kamtar/dykodac/pcb_render.png

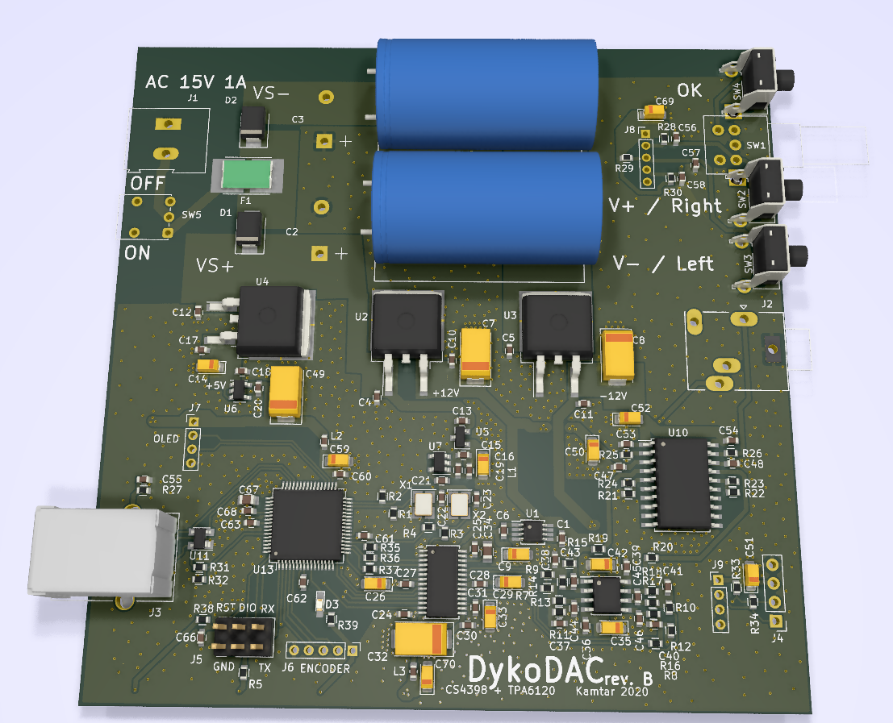
pcb_render.png
