kamtar/dykodac/pcb_design.png

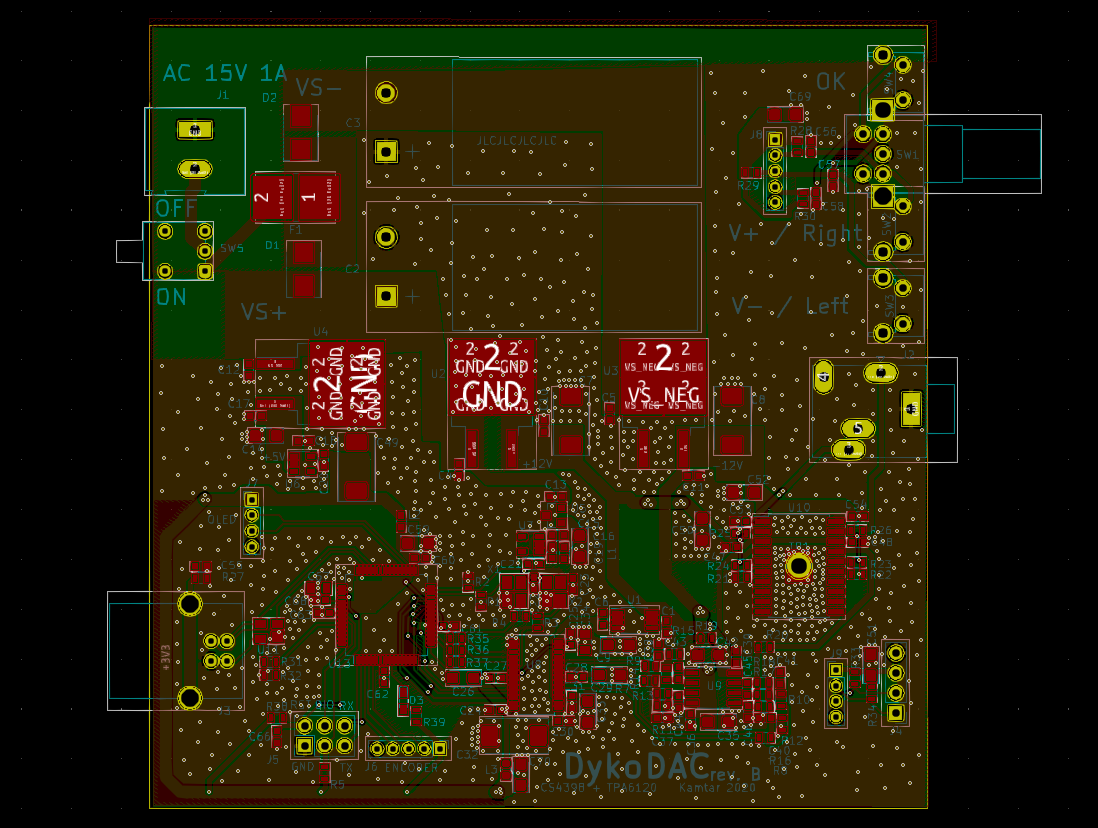
pcb_design.png
