kamtar/dykodac/schematics/DykoDAC.kicad_pcb

## KiCad design schematics/DykoDAC.kicad_pcb (2020-03-17)

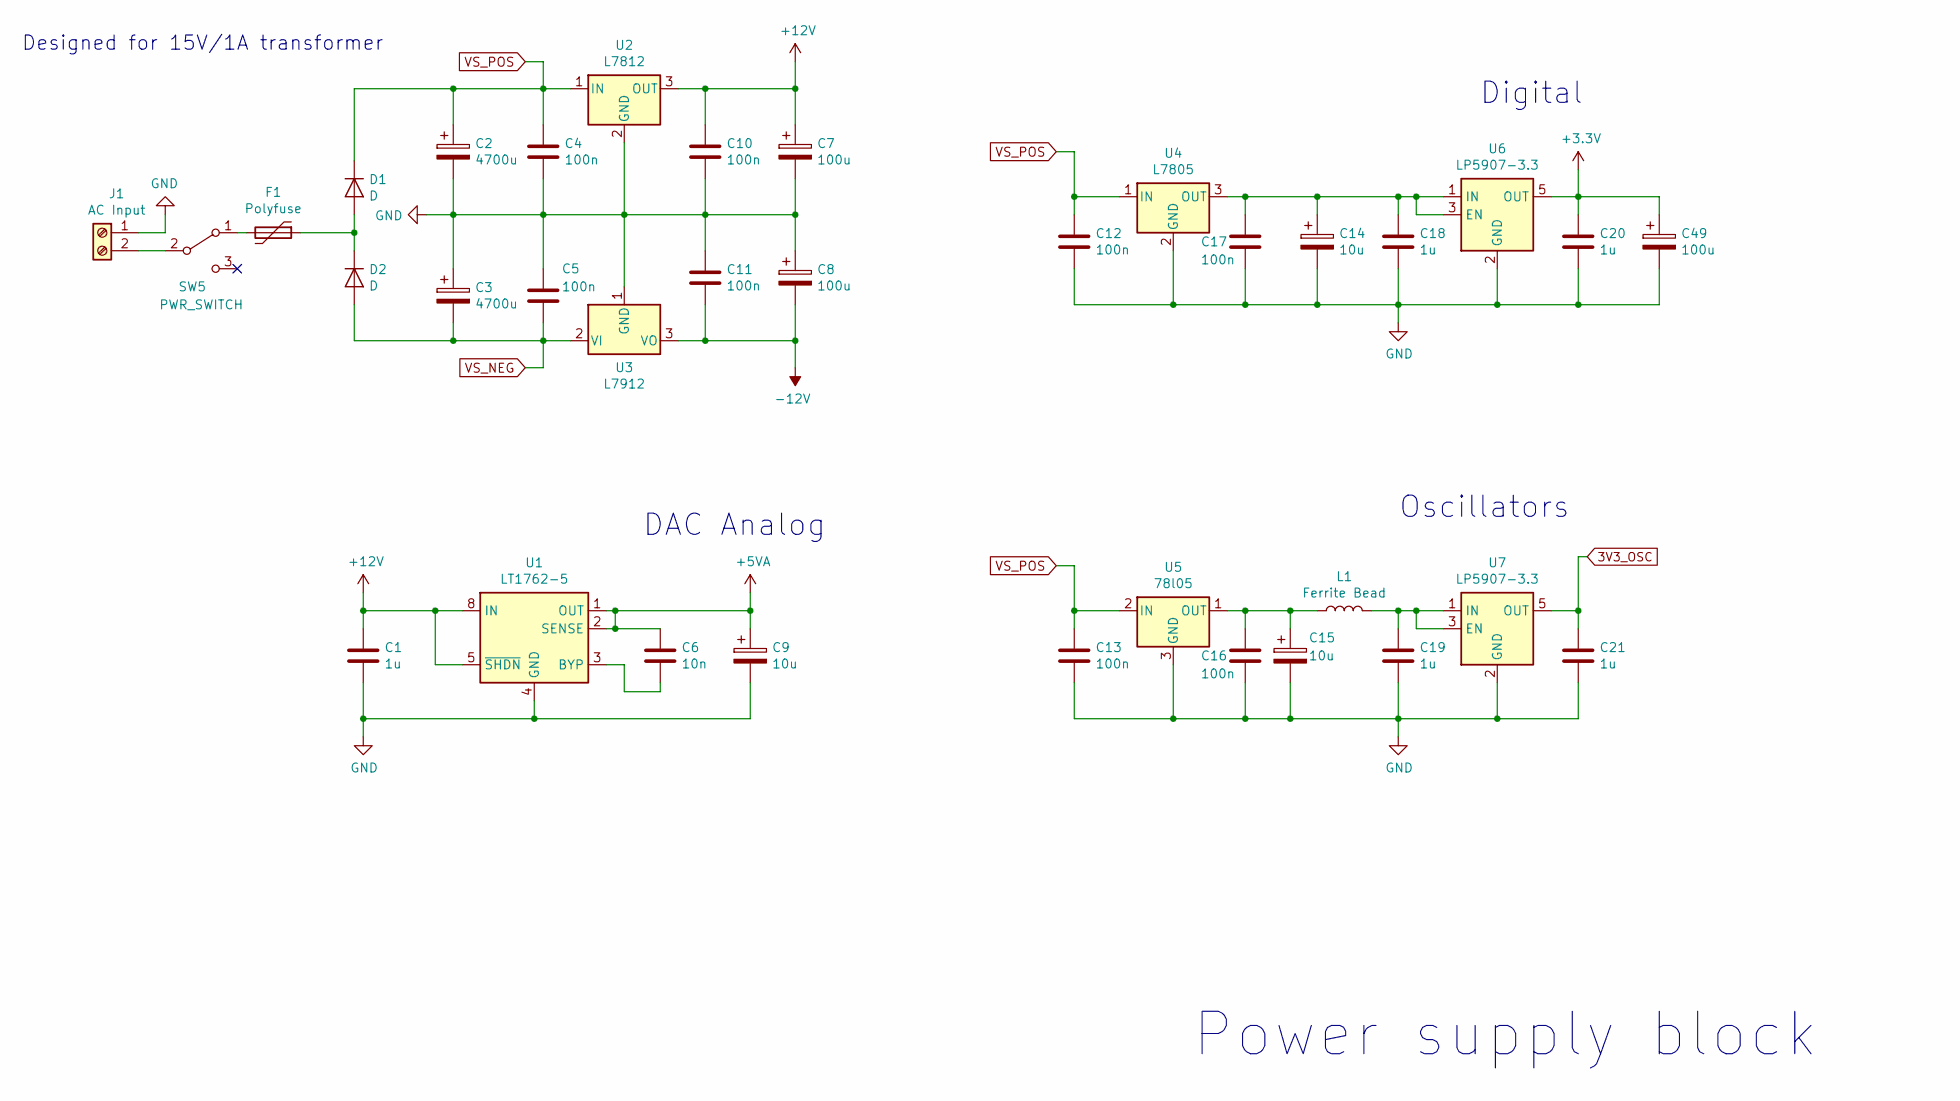
[picture p8: schematic DykoDAC_Power.sch, DykoDAC]

Parts:
C1, C18, C19, C20, C21: 1u; C_0603
C2, C3: 4700u; CP_Radial_D16.0mm_P7.50mm_Hor
C4, C5, C10, C11, C12, C13, C16, C17: 100n; C_0603
C6: 10n; C_0603
C7: 100u; CP_EIA-7343-31_Kemet-D; Part TAJD107K016SNJ
C8, C49: 100u; CP_EIA-7343-31_Kemet-D
C9: 10u; CP_EIA-3216-18_Kemet-A; Part T491A106K016AT
C14, C15: 10u; CP_EIA-3216-18_Kemet-A
D1, D2: D; D_SMB
F1: Polyfuse; UNIFuse_SMD2920
J1: AC Input; TerminalBlock_Altech_AK300-2_P5.00mm
L1: Ferrite Bead; C_0603
SW5: PWR_SWITCH; SW_Push_1P2T_Vertical_E-Switch_800UDP8P1A1M6
U1: LT1762-5; MSOP-8_3x3mm_Pitch0.65mm
U2: L7812; TO-263-2
U3: L7912; TO-263-2
U4: L7805; TO-263-2
U5: 78l05; SOT-23
U6, U7: LP5907-3.3; SOT-23-5

Connections:
3V3_OSC: C21.1, U7.5 (OUT); also elsewhere on the board
+5VA: C6.1, C9.1, U1.1 (OUT), U1.2 (SENSE); also elsewhere on the board
+12V: C1.1, C7.1, C10.1, U1.5 (~SHDN), U1.8 (IN), U2.3 (OUT); also elsewhere on the board
-12V: C8.2, C11.2, U3.3 (VO); also elsewhere on the board
GND: C1.2, C2.2, C3.1, C4.2, C5.1, C7.2, C8.1, C9.2, C10.2, C11.1, C12.2, C13.2, C14.2, C15.2, C16.2, C17.2, C18.2, C19.2, C20.2, C21.2, C49.2, J1.1, U1.4 (GND), U2.2 (GND), U3.1 (GND), U4.2 (GND), U5.3 (GND), U6.2 (GND), U7.2 (GND); also elsewhere on the board
unnamed: C6.2, U1.3 (BYP)
unnamed: C14.1, C17.1, C18.1, U4.3 (OUT), U6.1 (IN), U6.3 (EN)
unnamed: C15.1, C16.1, L1.1, U5.1 (OUT)
unnamed: C19.1, L1.2, U7.1 (IN), U7.3 (EN)
unnamed: D1.2 (A), D2.1 (K), F1.1
unnamed: F1.2, SW5.1 (A)
unnamed: J1.2, SW5.2 (B)
VS_NEG: C3.2, C5.2, D2.2 (A), U3.2 (VI)
VS_POS: C2.1, C4.1, C12.1, C13.1, D1.1 (K), U2.1 (IN), U4.1 (IN), U5.2 (IN)

Notes on the sheet:
Digital
DAC Analog
Power supply block
Oscillators
Designed for 15V/1A transformer

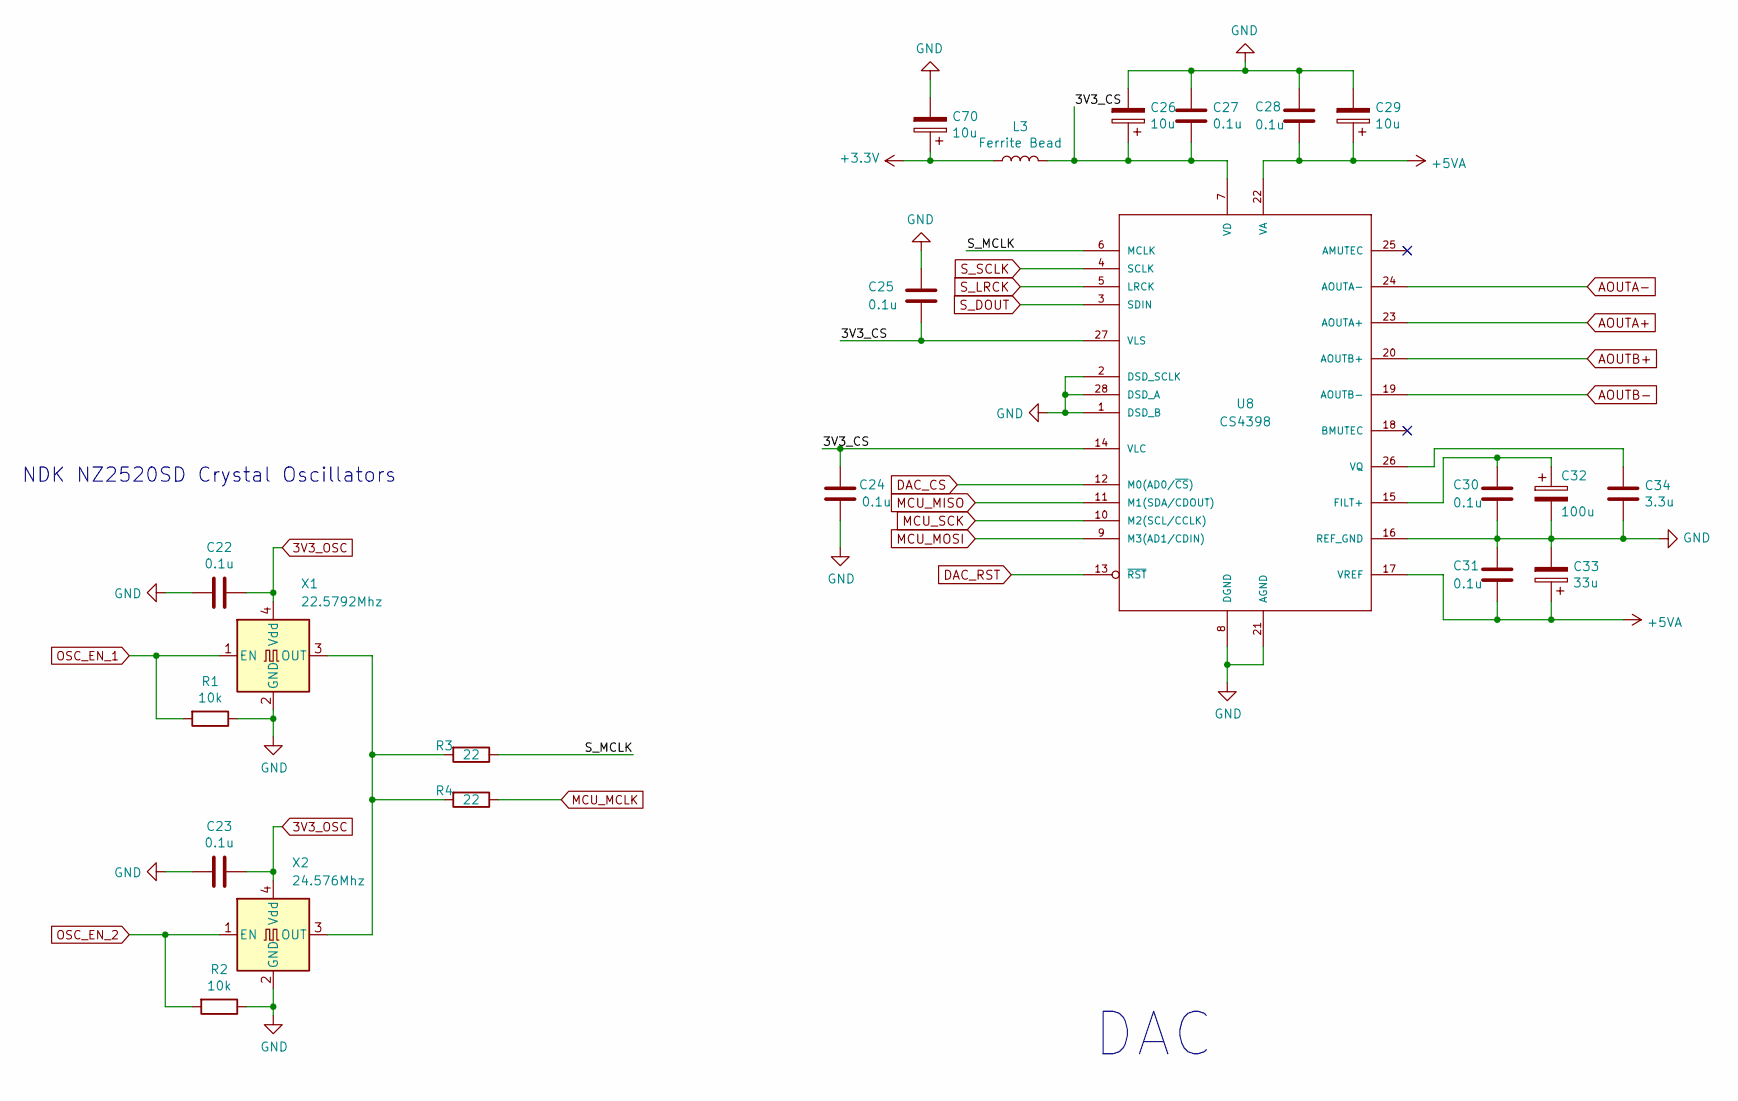
[picture p9: schematic DykoDAC_CS4398.sch, DykoDAC]

Parts:
C22, C23, C24, C25, C27, C28, C30, C31: 0.1u; C_0603
C26, C29, C70: 10u; CP_EIA-3216-18_Kemet-A
C32: 100u; CP_EIA-7343-31_Kemet-D; Part TAJD107K016SNJ
C33: 33u; CP_EIA-3216-18_Kemet-A
C34: 3.3u; C_0805
L3: Ferrite Bead; C_0603_1608Metric
R1, R2: 10k; R_0603
R3, R4: 22; R_0603
U8: CS4398; TSSOP-28_4.4x9.7mm_Pitch0.65mm
X1: 22.5792Mhz; Oscillator_SMD_SeikoEpson_SG210-4pin_2.5x2.0mm_HandSoldering; Part NDK NZ2520SD
X2: 24.576Mhz; Oscillator_SMD_SeikoEpson_SG210-4pin_2.5x2.0mm_HandSoldering; Part NDK NZ2520SD

Connections:
3V3_OSC: C22.1, C23.1, X1.4 (Vdd), X2.4 (Vdd); also elsewhere on the board
+5VA: C28.2, C29.1, C31.2, C33.1, U8.17 (VREF), U8.22 (VA); also elsewhere on the board
/DykoDAC_CS4398/3V3_CS: C24.1, C25.1, C26.1, C27.1, L3.2, U8.7 (VD), U8.14 (VLC), U8.27 (VLS)
/DykoDAC_CS4398/S_MCLK: R3.1, U8.6 (MCLK)
AOUTA+: U8.23 (AOUTA+); also elsewhere on the board
AOUTA-: U8.24 (AOUTA-); also elsewhere on the board
AOUTB+: U8.20 (AOUTB+); also elsewhere on the board
AOUTB-: U8.19 (AOUTB-); also elsewhere on the board
DAC_CS: U8.12 (M0(AD0/~CS~)); also elsewhere on the board
DAC_RST: U8.13 (~RST); also elsewhere on the board
GND: C22.2, C23.2, C24.2, C25.2, C26.2, C27.2, C28.1, C29.2, C30.2, C31.1, C32.2, C33.2, C34.2, C70.2, R1.1, R2.1, U8.1 (DSD_B), U8.2 (DSD_SCLK), U8.8 (DGND), U8.16 (REF_GND), U8.21 (AGND), U8.28 (DSD_A), X1.2 (GND), X2.2 (GND); also elsewhere on the board
MCU_MCLK: R4.1; also elsewhere on the board
MCU_MISO: U8.11 (M1(SDA/CDOUT)); also elsewhere on the board
MCU_MOSI: U8.9 (M3(AD1/CDIN)); also elsewhere on the board
MCU_SCK: U8.10 (M2(SCL/CCLK)); also elsewhere on the board
unnamed: C30.1, C32.1, U8.15 (FILT+)
unnamed: C34.1, U8.26 (VQ)
unnamed: R3.2, R4.2, X1.3 (OUT), X2.3 (OUT)
OSC_EN_1: R1.2, X1.1 (EN); also elsewhere on the board
OSC_EN_2: R2.2, X2.1 (EN); also elsewhere on the board
S_DOUT: U8.3 (SDIN); also elsewhere on the board
S_LRCK: U8.5 (LRCK); also elsewhere on the board
S_SCLK: U8.4 (SCLK); also elsewhere on the board

Notes on the sheet:
DAC
NDK NZ2520SD Crystal Oscillators

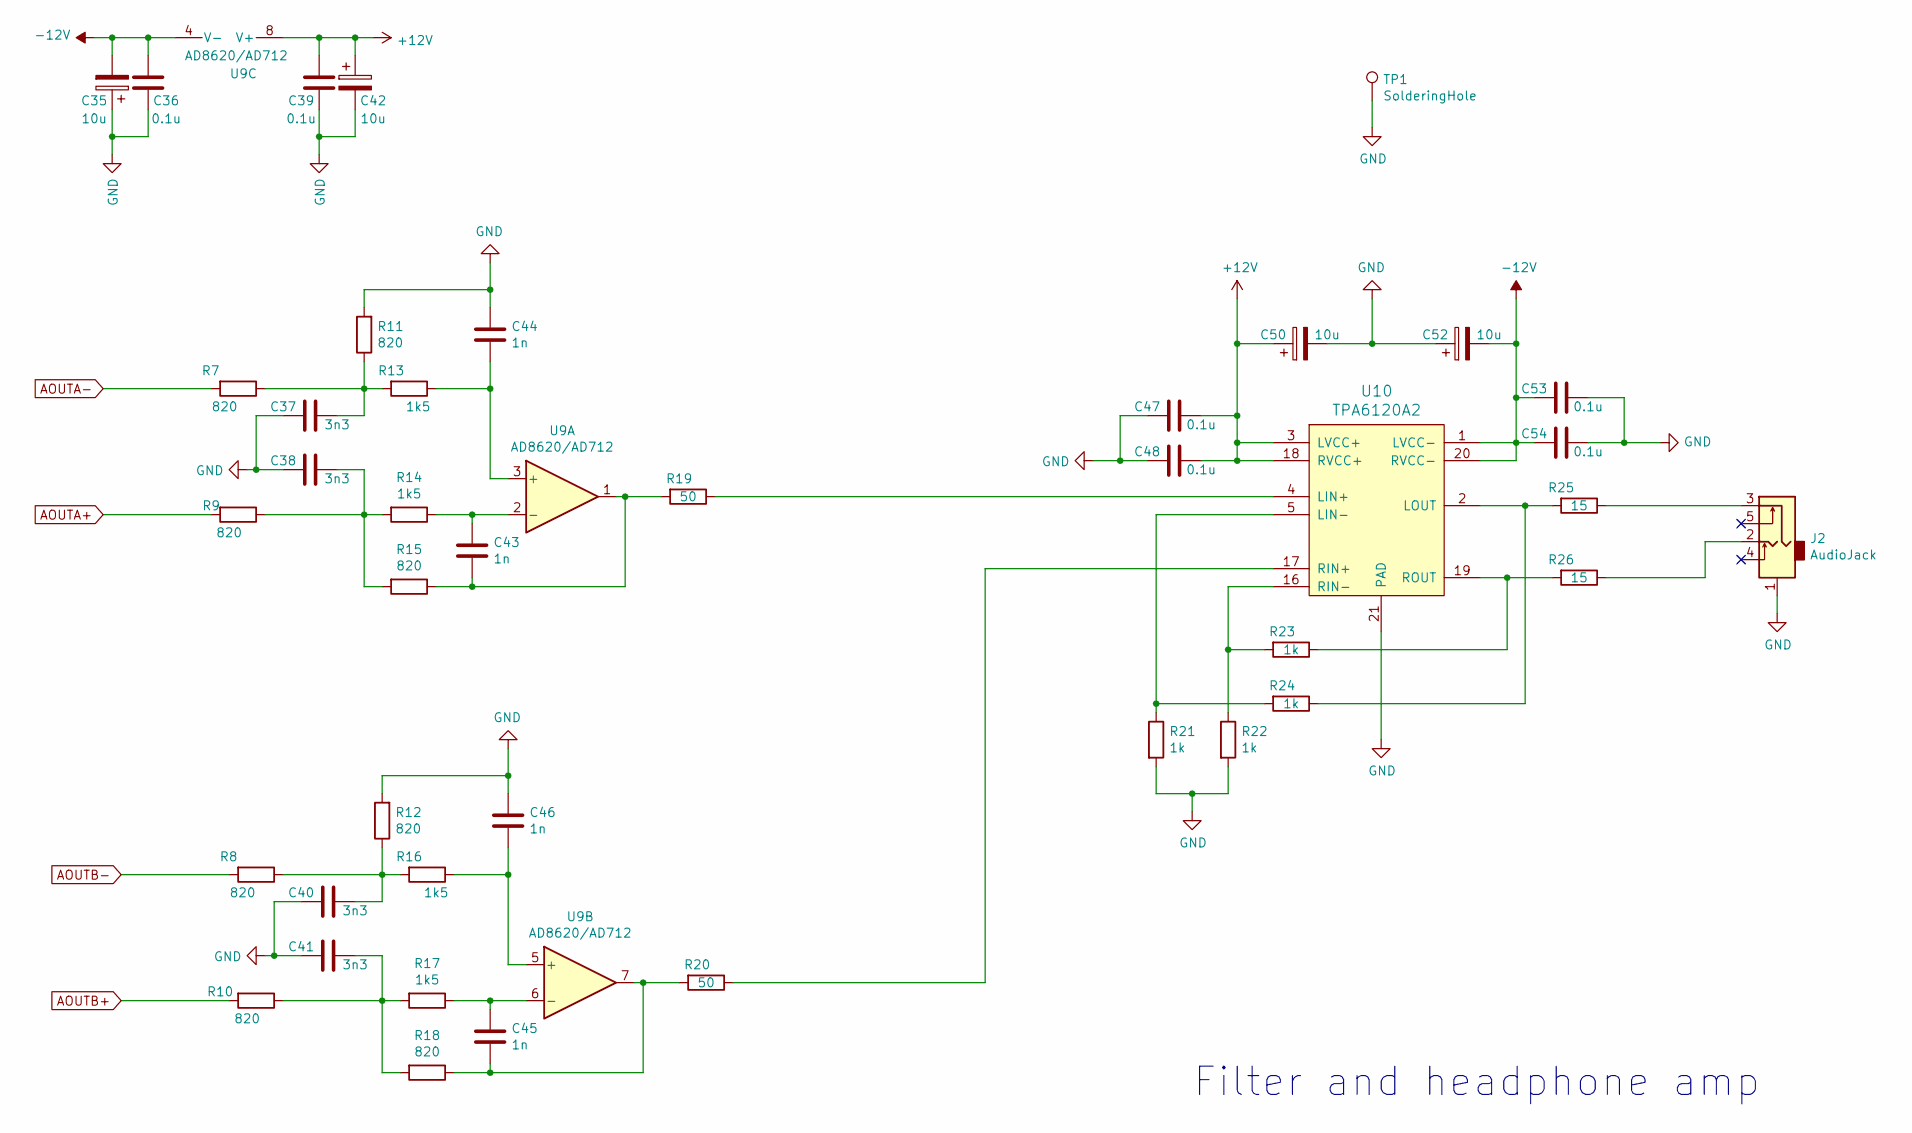
[picture p10: schematic DykoDAC_Output.sch, DykoDAC]

Parts:
C35, C42, C50, C52: 10u; CP_EIA-3216-18_Kemet-A
C36, C39, C47, C48, C53, C54: 0.1u; C_0603
C37, C38, C40, C41: 3n3; C_0603
C43, C44, C45, C46: 1n; C_0603
J2: AudioJack; StereoJack_3.5mm_Lumberg
R7, R8, R9, R10, R11, R12, R15, R18: 820; R_0603
R13, R14, R16, R17: 1k5; R_0603
R19, R20: 50; R_0603
R21, R22, R23, R24: 1k; R_0603
R25, R26: 15; R_0603
TP1: SolderingHole; TestPoint_Plated_Hole_D2.0mm
U9: AD8620/AD712; SOIC-8_3.9x4.9mm_Pitch1.27mm
U10: TPA6120A2; SOIC-20W_ThermalPad

Connections:
+12V: C39.2, C42.1, C47.1, C48.1, C50.1, U9.8 (V+), U10.3 (LVCC+), U10.18 (RVCC+); also elsewhere on the board
-12V: C35.2, C36.2, C52.2, C53.2, C54.2, U9.4 (V-), U10.1 (LVCC-), U10.20 (RVCC-); also elsewhere on the board
AOUTA+: R9.2; also elsewhere on the board
AOUTA-: R7.2; also elsewhere on the board
AOUTB+: R10.2; also elsewhere on the board
AOUTB-: R8.2; also elsewhere on the board
GND: C35.1, C36.1, C37.2, C38.2, C39.1, C40.2, C41.2, C42.2, C44.1, C46.1, C47.2, C48.2, C50.2, C52.1, C53.1, C54.1, J2.1, R11.2, R12.2, R21.2, R22.2, TP1.1, U10.21 (PAD); also elsewhere on the board
unnamed: C37.1, R7.1, R11.1, R13.2
unnamed: C38.1, R9.1, R14.2, R15.2
unnamed: C40.1, R8.1, R12.1, R16.2
unnamed: C41.1, R10.1, R17.2, R18.2
unnamed: C43.1, R14.1, U9.2 (-)
unnamed: C43.2, R15.1, R19.2, U9.1
unnamed: C44.2, R13.1, U9.3 (+)
unnamed: C45.1, R17.1, U9.6 (-)
unnamed: C45.2, R18.1, R20.2, U9.7
unnamed: C46.2, R16.1, U9.5 (+)
unnamed: J2.2, R26.1
unnamed: J2.3, R25.1
unnamed: R19.1, U10.4 (LIN+)
unnamed: R20.1, U10.17 (RIN+)
unnamed: R21.1, R24.2, U10.5 (LIN-)
unnamed: R22.1, R23.2, U10.16 (RIN-)
unnamed: R23.1, R26.2, U10.19 (ROUT)
unnamed: R24.1, R25.2, U10.2 (LOUT)

Notes on the sheet:
Filter and headphone amp

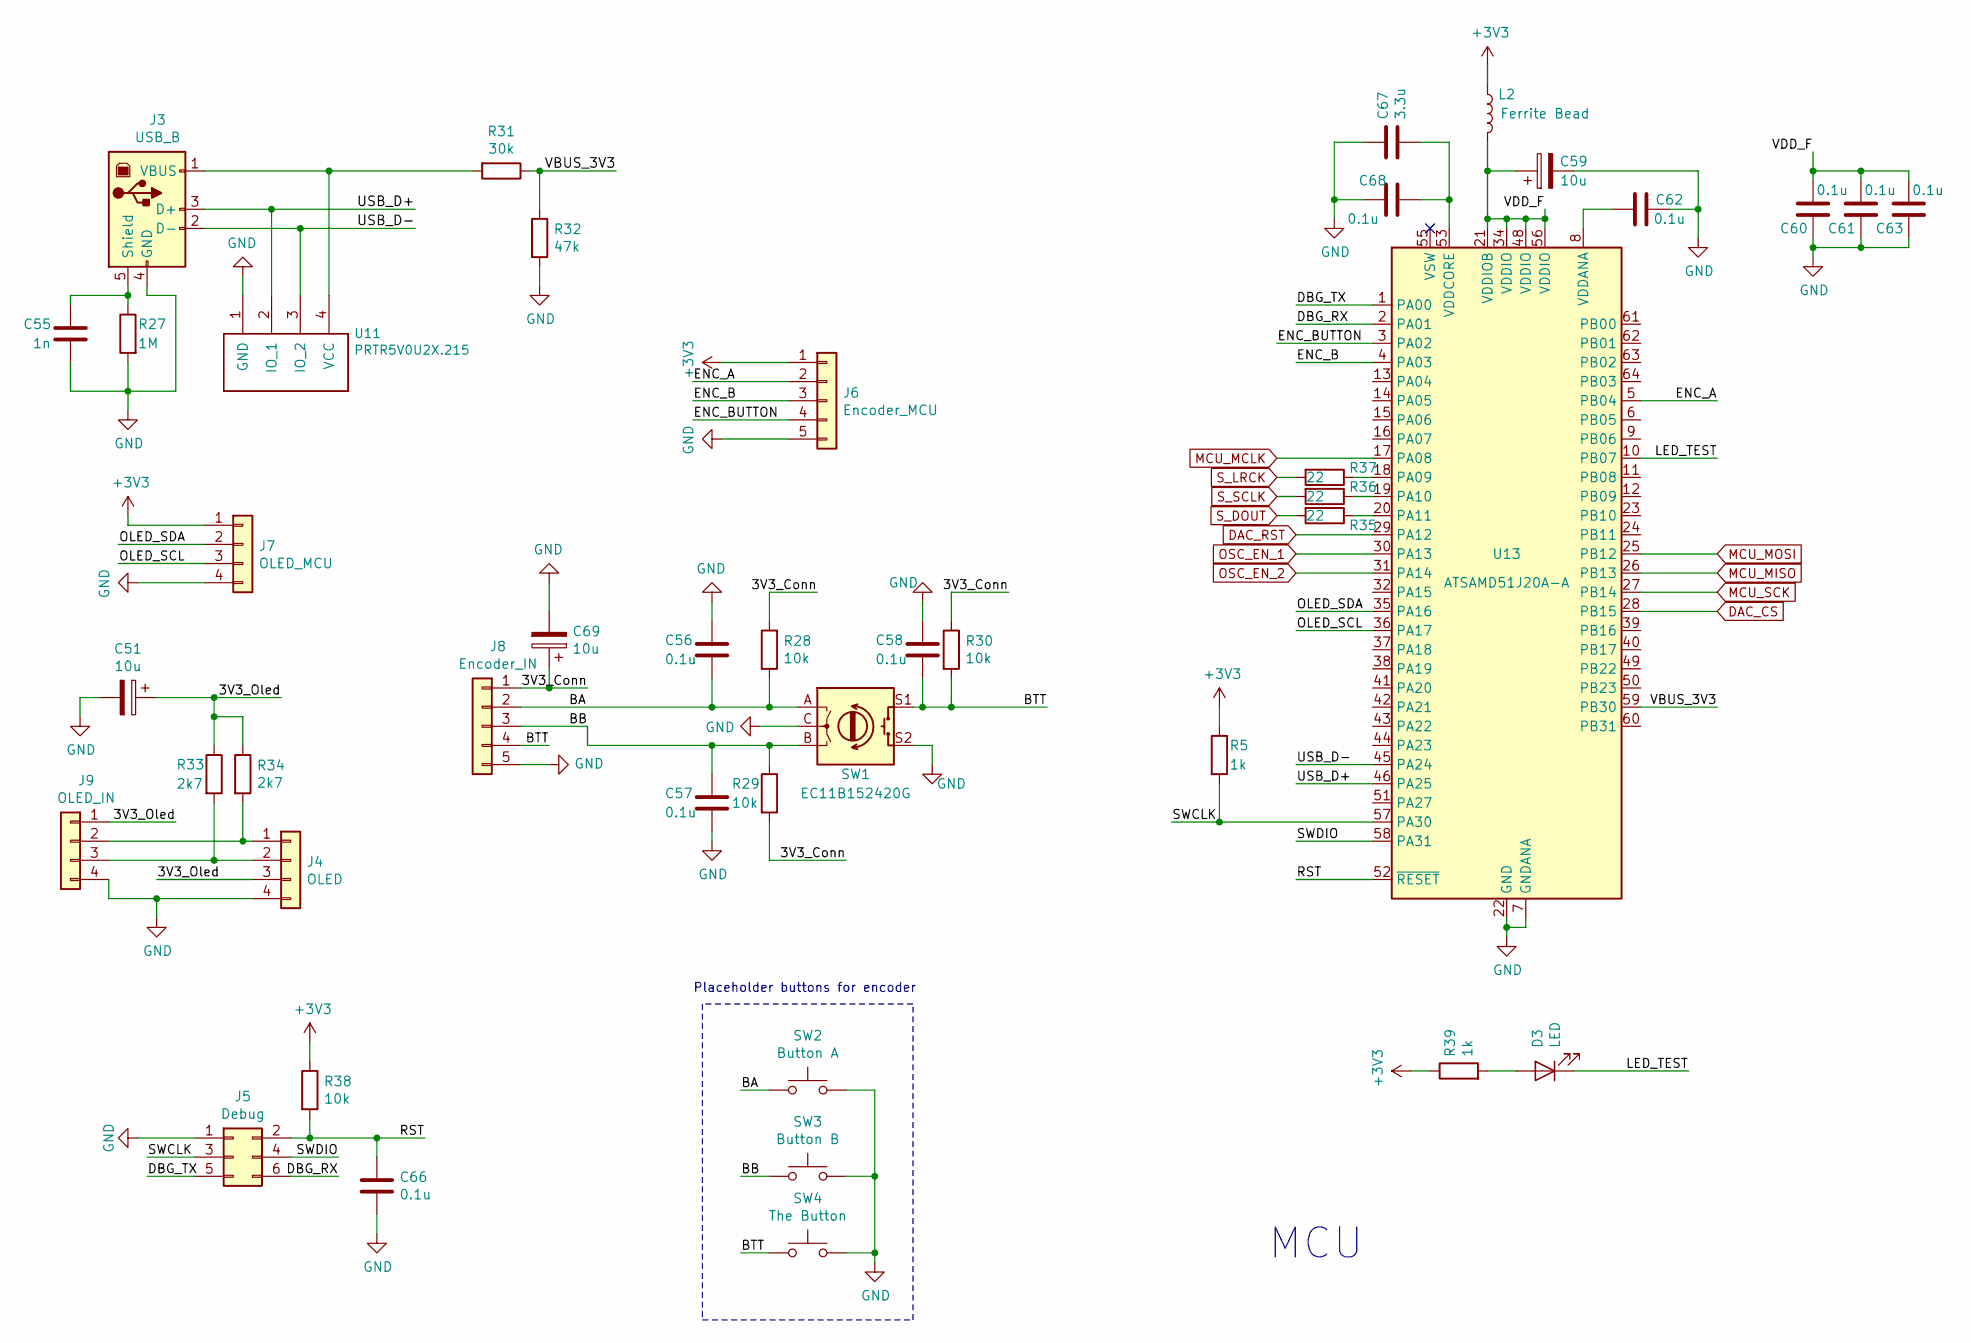
[picture p11: schematic DykoDAC_MCU.sch]

Parts:
C51, C59, C69: 10u; CP_EIA-3216-18_Kemet-A
C55: 1n; C_0603
C56, C57, C58, C60, C61, C62, C63, C66, C68: 0.1u; C_0603
C67: 3.3u; C_0805
D3: LED; LED_0603_HandSoldering
J3: USB_B
J4: OLED; Pin_Header_Straight_1x04_Pitch2.54mm
J5: Debug; Pin_Header_Straight_2x03_Pitch2.54mm
J6: Encoder_MCU; Pin_Header_Straight_1x05_Pitch2.00mm
J7: OLED_MCU; Pin_Header_Straight_1x04_Pitch2.00mm
J8: Encoder_IN; Pin_Header_Straight_1x05_Pitch2.00mm
J9: OLED_IN; Pin_Header_Straight_1x04_Pitch2.00mm
L2: Ferrite Bead; C_0603
R5, R39: 1k; R_0603
R27: 1M; R_0603
R28, R29, R30, R38: 10k; R_0603
R31: 30k; R_0603
R32: 47k; R_0603
R33, R34: 2k7; R_0603
R35, R36, R37: 22; R_0603
SW1: EC11B152420G; Potentiometer_Alps_RK097_Dual_Horizontal
SW2: Button A; SW_Tactile_SPST_Angled_PTS645Vx58-2LFS
SW3: Button B; SW_Tactile_SPST_Angled_PTS645Vx58-2LFS
SW4: The Button; SW_Tactile_SPST_Angled_PTS645Vx58-2LFS
U11: PRTR5V0U2X.215; SOT-143
U13: ATSAMD51J20A-A; LQFP-64_10x10mm_Pitch0.5mm

Connections:
/DykoDAC_MCU/3V3_Conn: C69.1, J8.1, R28.1, R29.2, R30.1
/DykoDAC_MCU/3V3_Oled: C51.1, J4.3, J9.1, R33.1, R34.1
/DykoDAC_MCU/BA: C56.2, J8.2, R28.2, SW1.A, SW2.1
/DykoDAC_MCU/BB: C57.1, J8.3, R29.1, SW1.B, SW3.1
/DykoDAC_MCU/BTT: C58.2, J8.4, R30.2, SW1.S1, SW4.1
/DykoDAC_MCU/DBG_RX: J5.6, U13.2 (PA01)
/DykoDAC_MCU/DBG_TX: J5.5, U13.1 (PA00)
/DykoDAC_MCU/ENC_A: J6.2, U13.5 (PB04)
/DykoDAC_MCU/ENC_B: J6.3, U13.4 (PA03)
/DykoDAC_MCU/ENC_BUTTON: J6.4, U13.3 (PA02)
/DykoDAC_MCU/LED_TEST: D3.1 (K), U13.10 (PB07)
/DykoDAC_MCU/OLED_SCL: J7.3, U13.36 (PA17)
/DykoDAC_MCU/OLED_SDA: J7.2, U13.35 (PA16)
/DykoDAC_MCU/RST: C66.1, J5.2, R38.2, U13.52 (~RESET)
/DykoDAC_MCU/SWCLK: J5.3, R5.2, U13.57 (PA30)
/DykoDAC_MCU/SWDIO: J5.4, U13.58 (PA31)
/DykoDAC_MCU/USB_D+: J3.3 (D+), U11.2 (IO_1), U13.46 (PA25)
/DykoDAC_MCU/USB_D-: J3.2 (D-), U11.3 (IO_2), U13.45 (PA24)
/DykoDAC_MCU/VBUS_3V3: R31.1, R32.1, U13.59 (PB30)
/DykoDAC_MCU/VDD_F: C59.1, C60.2, C61.2, C63.2, L2.2, U13.21 (VDDIOB), U13.34 (VDDIO), U13.48 (VDDIO), U13.56 (VDDIO)
DAC_CS: U13.28 (PB15); also elsewhere on the board
DAC_RST: U13.29 (PA12); also elsewhere on the board
GND: C51.2, C55.2, C56.1, C57.2, C58.1, C59.2, C60.1, C61.1, C62.1, C63.1, C66.2, C67.1, C68.2, C69.2, J3.4 (GND), J4.4, J5.1, J6.5, J7.4, J8.5, J9.4, R27.2, R32.2, SW1.C, SW1.S2, SW2.2, SW3.2, SW4.2, U11.1 (GND), U13.7 (GNDANA), U13.22 (GND), U13.33 (GND), U13.47 (GND), U13.54 (GND); also elsewhere on the board
MCU_MCLK: U13.17 (PA08); also elsewhere on the board
MCU_MISO: U13.26 (PB13); also elsewhere on the board
MCU_MOSI: U13.25 (PB12); also elsewhere on the board
MCU_SCK: U13.27 (PB14); also elsewhere on the board
unnamed: C55.1, J3.5 (Shield), R27.1
unnamed: C62.2, U13.8 (VDDANA)
unnamed: C67.2, C68.1, U13.53 (VDDCORE)
unnamed: D3.2 (A), R39.2
unnamed: J3.1 (VBUS), R31.2, U11.4 (VCC)
unnamed: J4.1, J9.2, R34.2
unnamed: J4.2, J9.3, R33.2
unnamed: R35.1, U13.20 (PA11)
unnamed: R36.1, U13.19 (PA10)
unnamed: R37.1, U13.18 (PA09)
OSC_EN_1: U13.30 (PA13); also elsewhere on the board
OSC_EN_2: U13.31 (PA14); also elsewhere on the board
S_DOUT: R35.2; also elsewhere on the board
S_LRCK: R37.2; also elsewhere on the board
S_SCLK: R36.2; also elsewhere on the board

Notes on the sheet:
MCU
Placeholder buttons for encoder

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
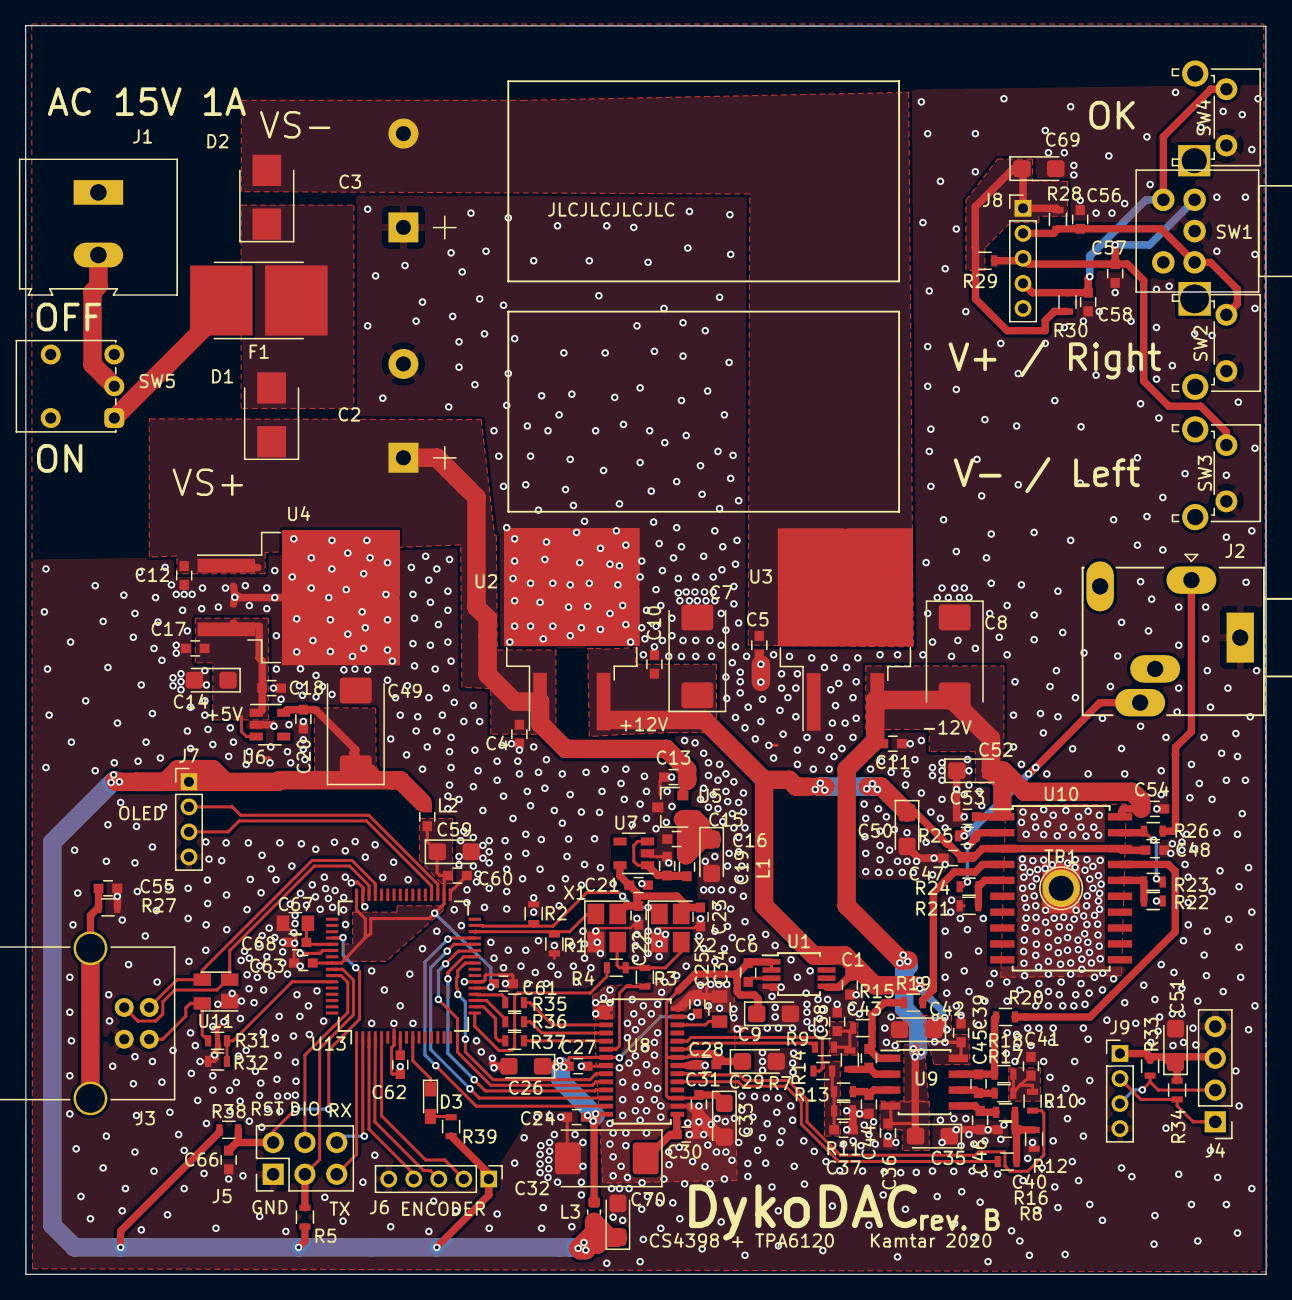
[picture p12: board DykoDAC.kicad_pcb from above]

Board: 2 copper layers, 99.2 x 99.8 mm, 142 parts (0 on the bottom side), 83 nets.
