kamtar/dykodac/fw/src/driver_init.c

/*
 * Code generated from Atmel Start.
 *
 * This file will be overwritten when reconfiguring your Atmel Start project.
 * Please copy examples or other code you want to keep to a separate file
 * to avoid losing it when reconfiguring.
 */

#include "driver_init.h"
#include <peripheral_clk_config.h>
#include <utils.h>
#include <hal_init.h>

#include <hpl_rtc_base.h>

struct timer_descriptor      TIMER_0;
struct spi_m_sync_descriptor SPI_0;

struct i2s_c_sync_desc I2S_0_0;

struct flash_descriptor FLASH_0;


struct i2c_m_sync_desc I2C_0;

struct wdt_descriptor WDT_0;

void EVENT_SYSTEM_0_init(void)
{

	hri_mclk_set_APBBMASK_EVSYS_bit(MCLK);

	event_system_init();
}

void I2S_0_PORT_init(void)
{

	gpio_set_pin_direction(PA09,
	                       // <y> Pin direction
	                       // <id> pad_direction
	                       // <GPIO_DIRECTION_OFF"> Off
	                       // <GPIO_DIRECTION_IN"> In
	                       // <GPIO_DIRECTION_OUT"> Out
	                       GPIO_DIRECTION_OUT);

	gpio_set_pin_level(PA09,
	                   // <y> Initial level
	                   // <id> pad_initial_level
	                   // <false"> Low
	                   // <true"> High
	                   false);

	gpio_set_pin_pull_mode(PA09,
	                       // <y> Pull configuration
	                       // <id> pad_pull_config
	                       // <GPIO_PULL_OFF"> Off
	                       // <GPIO_PULL_UP"> Pull-up
	                       // <GPIO_PULL_DOWN"> Pull-down
	                       GPIO_PULL_OFF);

	gpio_set_pin_function(PA09,
	                      // <y> Pin function
	                      // <id> pad_function
	                      // <i> Auto : use driver pinmux if signal is imported by driver, else turn off function
	                      // <PINMUX_PA09J_I2S_FS0"> Auto
	                      // <GPIO_PIN_FUNCTION_OFF"> Off
	                      // <GPIO_PIN_FUNCTION_A"> A
	                      // <GPIO_PIN_FUNCTION_B"> B
	                      // <GPIO_PIN_FUNCTION_C"> C
	                      // <GPIO_PIN_FUNCTION_D"> D
	                      // <GPIO_PIN_FUNCTION_E"> E
	                      // <GPIO_PIN_FUNCTION_F"> F
	                      // <GPIO_PIN_FUNCTION_G"> G
	                      // <GPIO_PIN_FUNCTION_H"> H
	                      // <GPIO_PIN_FUNCTION_I"> I
	                      // <GPIO_PIN_FUNCTION_J"> J
	                      // <GPIO_PIN_FUNCTION_K"> K
	                      // <GPIO_PIN_FUNCTION_L"> L
	                      // <GPIO_PIN_FUNCTION_M"> M
	                      // <GPIO_PIN_FUNCTION_N"> N
	                      PINMUX_PA09J_I2S_FS0);

	gpio_set_pin_direction(PA08,
	                       // <y> Pin direction
	                       // <id> pad_direction
	                       // <GPIO_DIRECTION_OFF"> Off
	                       // <GPIO_DIRECTION_IN"> In
	                       // <GPIO_DIRECTION_OUT"> Out
	                       GPIO_DIRECTION_IN);

	gpio_set_pin_level(PA08,
	                   // <y> Initial level
	                   // <id> pad_initial_level
	                   // <false"> Low
	                   // <true"> High
	                   false);

	gpio_set_pin_pull_mode(PA08,
	                       // <y> Pull configuration
	                       // <id> pad_pull_config
	                       // <GPIO_PULL_OFF"> Off
	                       // <GPIO_PULL_UP"> Pull-up
	                       // <GPIO_PULL_DOWN"> Pull-down
	                       GPIO_PULL_OFF);

	gpio_set_pin_function(PA08,
	                      // <y> Pin function
	                      // <id> pad_function
	                      // <i> Auto : use driver pinmux if signal is imported by driver, else turn off function
	                      // <PINMUX_PA08J_I2S_MCK0"> Auto
	                      // <GPIO_PIN_FUNCTION_OFF"> Off
	                      // <GPIO_PIN_FUNCTION_A"> A
	                      // <GPIO_PIN_FUNCTION_B"> B
	                      // <GPIO_PIN_FUNCTION_C"> C
	                      // <GPIO_PIN_FUNCTION_D"> D
	                      // <GPIO_PIN_FUNCTION_E"> E
	                      // <GPIO_PIN_FUNCTION_F"> F
	                      // <GPIO_PIN_FUNCTION_G"> G
	                      // <GPIO_PIN_FUNCTION_H"> H
	                      // <GPIO_PIN_FUNCTION_I"> I
	                      // <GPIO_PIN_FUNCTION_J"> J
	                      // <GPIO_PIN_FUNCTION_K"> K
	                      // <GPIO_PIN_FUNCTION_L"> L
	                      // <GPIO_PIN_FUNCTION_M"> M
	                      // <GPIO_PIN_FUNCTION_N"> N
	                      PINMUX_PA08J_I2S_MCK0);

	gpio_set_pin_direction(PA10,
	                       // <y> Pin direction
	                       // <id> pad_direction
	                       // <GPIO_DIRECTION_OFF"> Off
	                       // <GPIO_DIRECTION_IN"> In
	                       // <GPIO_DIRECTION_OUT"> Out
	                       GPIO_DIRECTION_OUT);

	gpio_set_pin_level(PA10,
	                   // <y> Initial level
	                   // <id> pad_initial_level
	                   // <false"> Low
	                   // <true"> High
	                   false);

	gpio_set_pin_pull_mode(PA10,
	                       // <y> Pull configuration
	                       // <id> pad_pull_config
	                       // <GPIO_PULL_OFF"> Off
	                       // <GPIO_PULL_UP"> Pull-up
	                       // <GPIO_PULL_DOWN"> Pull-down
	                       GPIO_PULL_OFF);

	gpio_set_pin_function(PA10,
	                      // <y> Pin function
	                      // <id> pad_function
	                      // <i> Auto : use driver pinmux if signal is imported by driver, else turn off function
	                      // <PINMUX_PA10J_I2S_SCK0"> Auto
	                      // <GPIO_PIN_FUNCTION_OFF"> Off
	                      // <GPIO_PIN_FUNCTION_A"> A
	                      // <GPIO_PIN_FUNCTION_B"> B
	                      // <GPIO_PIN_FUNCTION_C"> C
	                      // <GPIO_PIN_FUNCTION_D"> D
	                      // <GPIO_PIN_FUNCTION_E"> E
	                      // <GPIO_PIN_FUNCTION_F"> F
	                      // <GPIO_PIN_FUNCTION_G"> G
	                      // <GPIO_PIN_FUNCTION_H"> H
	                      // <GPIO_PIN_FUNCTION_I"> I
	                      // <GPIO_PIN_FUNCTION_J"> J
	                      // <GPIO_PIN_FUNCTION_K"> K
	                      // <GPIO_PIN_FUNCTION_L"> L
	                      // <GPIO_PIN_FUNCTION_M"> M
	                      // <GPIO_PIN_FUNCTION_N"> N
	                      PINMUX_PA10J_I2S_SCK0);

	gpio_set_pin_direction(PA11,
	                       // <y> Pin direction
	                       // <id> pad_direction
	                       // <GPIO_DIRECTION_OFF"> Off
	                       // <GPIO_DIRECTION_IN"> In
	                       // <GPIO_DIRECTION_OUT"> Out
	                       GPIO_DIRECTION_OUT);

	gpio_set_pin_level(PA11,
	                   // <y> Initial level
	                   // <id> pad_initial_level
	                   // <false"> Low
	                   // <true"> High
	                   false);

	gpio_set_pin_pull_mode(PA11,
	                       // <y> Pull configuration
	                       // <id> pad_pull_config
	                       // <GPIO_PULL_OFF"> Off
	                       // <GPIO_PULL_UP"> Pull-up
	                       // <GPIO_PULL_DOWN"> Pull-down
	                       GPIO_PULL_OFF);

	gpio_set_pin_function(PA11,
	                      // <y> Pin function
	                      // <id> pad_function
	                      // <i> Auto : use driver pinmux if signal is imported by driver, else turn off function
	                      // <PINMUX_PA11J_I2S_SDO"> Auto
	                      // <GPIO_PIN_FUNCTION_OFF"> Off
	                      // <GPIO_PIN_FUNCTION_A"> A
	                      // <GPIO_PIN_FUNCTION_B"> B
	                      // <GPIO_PIN_FUNCTION_C"> C
	                      // <GPIO_PIN_FUNCTION_D"> D
	                      // <GPIO_PIN_FUNCTION_E"> E
	                      // <GPIO_PIN_FUNCTION_F"> F
	                      // <GPIO_PIN_FUNCTION_G"> G
	                      // <GPIO_PIN_FUNCTION_H"> H
	                      // <GPIO_PIN_FUNCTION_I"> I
	                      // <GPIO_PIN_FUNCTION_J"> J
	                      // <GPIO_PIN_FUNCTION_K"> K
	                      // <GPIO_PIN_FUNCTION_L"> L
	                      // <GPIO_PIN_FUNCTION_M"> M
	                      // <GPIO_PIN_FUNCTION_N"> N
	                      PINMUX_PA11J_I2S_SDO);
}

void I2S_0_CLOCK_init(void)
{
	hri_mclk_set_APBDMASK_I2S_bit(MCLK);
	hri_gclk_write_PCHCTRL_reg(GCLK, I2S_GCLK_ID_0, CONF_GCLK_I2S_SRC_0 | (1 << GCLK_PCHCTRL_CHEN_Pos));
	hri_gclk_write_PCHCTRL_reg(GCLK, I2S_GCLK_ID_1, CONF_GCLK_I2S_SRC_1 | (1 << GCLK_PCHCTRL_CHEN_Pos));
}

void I2S_0_init(void)
{
	I2S_0_CLOCK_init();
	i2s_c_sync_init(&I2S_0_0, I2S, I2S_C_IFACE_0);
	I2S_0_PORT_init();
	i2s_c_sync_enable(&I2S_0_0);

}

void FLASH_0_CLOCK_init(void)
{

	hri_mclk_set_AHBMASK_NVMCTRL_bit(MCLK);
}

void FLASH_0_init(void)
{
	FLASH_0_CLOCK_init();
	flash_init(&FLASH_0, NVMCTRL);
}

/**
 * \brief Timer initialization function
 *
 * Enables Timer peripheral, clocks and initializes Timer driver
 */
static void TIMER_0_init(void)
{
	hri_mclk_set_APBAMASK_RTC_bit(MCLK);
	timer_init(&TIMER_0, RTC, _rtc_get_timer());
}

void USART_0_PORT_init(void)
{

	gpio_set_pin_function(PA00, PINMUX_PA00D_SERCOM1_PAD0);

	gpio_set_pin_function(PA01, PINMUX_PA01D_SERCOM1_PAD1);
}

void USART_0_CLOCK_init(void)
{
	//hri_gclk_write_PCHCTRL_reg(GCLK, SERCOM1_GCLK_ID_CORE, CONF_GCLK_SERCOM1_CORE_SRC | (1 << GCLK_PCHCTRL_CHEN_Pos));
	//hri_gclk_write_PCHCTRL_reg(GCLK, SERCOM1_GCLK_ID_SLOW, CONF_GCLK_SERCOM1_SLOW_SRC | (1 << GCLK_PCHCTRL_CHEN_Pos));

	hri_mclk_set_APBAMASK_SERCOM1_bit(MCLK);
}



void I2C_0_PORT_init(void)
{

	gpio_set_pin_pull_mode(PA17,
	                       // <y> Pull configuration
	                       // <id> pad_pull_config
	                       // <GPIO_PULL_OFF"> Off
	                       // <GPIO_PULL_UP"> Pull-up
	                       // <GPIO_PULL_DOWN"> Pull-down
	                       GPIO_PULL_OFF);

	gpio_set_pin_function(PA17, PINMUX_PA17D_SERCOM3_PAD0);

	gpio_set_pin_pull_mode(PA16,
	                       // <y> Pull configuration
	                       // <id> pad_pull_config
	                       // <GPIO_PULL_OFF"> Off
	                       // <GPIO_PULL_UP"> Pull-up
	                       // <GPIO_PULL_DOWN"> Pull-down
	                       GPIO_PULL_OFF);

	gpio_set_pin_function(PA16, PINMUX_PA16D_SERCOM3_PAD1);
}

void I2C_0_CLOCK_init(void)
{
	hri_gclk_write_PCHCTRL_reg(GCLK, SERCOM3_GCLK_ID_CORE, CONF_GCLK_SERCOM3_CORE_SRC | (1 << GCLK_PCHCTRL_CHEN_Pos));
	hri_gclk_write_PCHCTRL_reg(GCLK, SERCOM3_GCLK_ID_SLOW, CONF_GCLK_SERCOM3_SLOW_SRC | (1 << GCLK_PCHCTRL_CHEN_Pos));

	hri_mclk_set_APBBMASK_SERCOM3_bit(MCLK);
}

void I2C_0_init(void)
{
	I2C_0_CLOCK_init();
	i2c_m_sync_init(&I2C_0, SERCOM3);
	I2C_0_PORT_init();
}

void SPI_0_PORT_init(void)
{

	gpio_set_pin_level(PB12,
	                   // <y> Initial level
	                   // <id> pad_initial_level
	                   // <false"> Low
	                   // <true"> High
	                   false);

	// Set pin direction to output
	gpio_set_pin_direction(PB12, GPIO_DIRECTION_OUT);

	gpio_set_pin_function(PB12, PINMUX_PB12C_SERCOM4_PAD0);

	gpio_set_pin_level(PB13,
	                   // <y> Initial level
	                   // <id> pad_initial_level
	                   // <false"> Low
	                   // <true"> High
	                   false);

	// Set pin direction to output
	gpio_set_pin_direction(PB13, GPIO_DIRECTION_OUT);

	gpio_set_pin_function(PB13, PINMUX_PB13C_SERCOM4_PAD1);

	// Set pin direction to input
	gpio_set_pin_direction(PB14, GPIO_DIRECTION_IN);

	gpio_set_pin_pull_mode(PB14,
	                       // <y> Pull configuration
	                       // <id> pad_pull_config
	                       // <GPIO_PULL_OFF"> Off
	                       // <GPIO_PULL_UP"> Pull-up
	                       // <GPIO_PULL_DOWN"> Pull-down
	                       GPIO_PULL_OFF);

	gpio_set_pin_function(PB14, PINMUX_PB14C_SERCOM4_PAD2);
}

void SPI_0_CLOCK_init(void)
{
	hri_gclk_write_PCHCTRL_reg(GCLK, SERCOM4_GCLK_ID_CORE, CONF_GCLK_SERCOM4_CORE_SRC | (1 << GCLK_PCHCTRL_CHEN_Pos));
	hri_gclk_write_PCHCTRL_reg(GCLK, SERCOM4_GCLK_ID_SLOW, CONF_GCLK_SERCOM4_SLOW_SRC | (1 << GCLK_PCHCTRL_CHEN_Pos));

	hri_mclk_set_APBDMASK_SERCOM4_bit(MCLK);
}

void SPI_0_init(void)
{
	SPI_0_CLOCK_init();
	spi_m_sync_init(&SPI_0, SERCOM4);
	SPI_0_PORT_init();

}

void delay_driver_init(void)
{
	delay_init(SysTick);
}

void USB_0_PORT_init(void)
{

	gpio_set_pin_direction(PA24,
	                       // <y> Pin direction
	                       // <id> pad_direction
	                       // <GPIO_DIRECTION_OFF"> Off
	                       // <GPIO_DIRECTION_IN"> In
	                       // <GPIO_DIRECTION_OUT"> Out
	                       GPIO_DIRECTION_OUT);

	gpio_set_pin_level(PA24,
	                   // <y> Initial level
	                   // <id> pad_initial_level
	                   // <false"> Low
	                   // <true"> High
	                   false);

	gpio_set_pin_pull_mode(PA24,
	                       // <y> Pull configuration
	                       // <id> pad_pull_config
	                       // <GPIO_PULL_OFF"> Off
	                       // <GPIO_PULL_UP"> Pull-up
	                       // <GPIO_PULL_DOWN"> Pull-down
	                       GPIO_PULL_OFF);

	gpio_set_pin_function(PA24,
	                      // <y> Pin function
	                      // <id> pad_function
	                      // <i> Auto : use driver pinmux if signal is imported by driver, else turn off function
	                      // <PINMUX_PA24H_USB_DM"> Auto
	                      // <GPIO_PIN_FUNCTION_OFF"> Off
	                      // <GPIO_PIN_FUNCTION_A"> A
	                      // <GPIO_PIN_FUNCTION_B"> B
	                      // <GPIO_PIN_FUNCTION_C"> C
	                      // <GPIO_PIN_FUNCTION_D"> D
	                      // <GPIO_PIN_FUNCTION_E"> E
	                      // <GPIO_PIN_FUNCTION_F"> F
	                      // <GPIO_PIN_FUNCTION_G"> G
	                      // <GPIO_PIN_FUNCTION_H"> H
	                      // <GPIO_PIN_FUNCTION_I"> I
	                      // <GPIO_PIN_FUNCTION_J"> J
	                      // <GPIO_PIN_FUNCTION_K"> K
	                      // <GPIO_PIN_FUNCTION_L"> L
	                      // <GPIO_PIN_FUNCTION_M"> M
	                      // <GPIO_PIN_FUNCTION_N"> N
	                      PINMUX_PA24H_USB_DM);

	gpio_set_pin_direction(PA25,
	                       // <y> Pin direction
	                       // <id> pad_direction
	                       // <GPIO_DIRECTION_OFF"> Off
	                       // <GPIO_DIRECTION_IN"> In
	                       // <GPIO_DIRECTION_OUT"> Out
	                       GPIO_DIRECTION_OUT);

	gpio_set_pin_level(PA25,
	                   // <y> Initial level
	                   // <id> pad_initial_level
	                   // <false"> Low
	                   // <true"> High
	                   false);

	gpio_set_pin_pull_mode(PA25,
	                       // <y> Pull configuration
	                       // <id> pad_pull_config
	                       // <GPIO_PULL_OFF"> Off
	                       // <GPIO_PULL_UP"> Pull-up
	                       // <GPIO_PULL_DOWN"> Pull-down
	                       GPIO_PULL_OFF);

	gpio_set_pin_function(PA25,
	                      // <y> Pin function
	                      // <id> pad_function
	                      // <i> Auto : use driver pinmux if signal is imported by driver, else turn off function
	                      // <PINMUX_PA25H_USB_DP"> Auto
	                      // <GPIO_PIN_FUNCTION_OFF"> Off
	                      // <GPIO_PIN_FUNCTION_A"> A
	                      // <GPIO_PIN_FUNCTION_B"> B
	                      // <GPIO_PIN_FUNCTION_C"> C
	                      // <GPIO_PIN_FUNCTION_D"> D
	                      // <GPIO_PIN_FUNCTION_E"> E
	                      // <GPIO_PIN_FUNCTION_F"> F
	                      // <GPIO_PIN_FUNCTION_G"> G
	                      // <GPIO_PIN_FUNCTION_H"> H
	                      // <GPIO_PIN_FUNCTION_I"> I
	                      // <GPIO_PIN_FUNCTION_J"> J
	                      // <GPIO_PIN_FUNCTION_K"> K
	                      // <GPIO_PIN_FUNCTION_L"> L
	                      // <GPIO_PIN_FUNCTION_M"> M
	                      // <GPIO_PIN_FUNCTION_N"> N
	                      PINMUX_PA25H_USB_DP);

	gpio_set_pin_direction(PA23,
		                       // <y> Pin direction
		                       // <id> pad_direction
		                       // <GPIO_DIRECTION_OFF"> Off
		                       // <GPIO_DIRECTION_IN"> In
		                       // <GPIO_DIRECTION_OUT"> Out
		                       GPIO_DIRECTION_OUT);

		gpio_set_pin_level(PA23,
		                   // <y> Initial level
		                   // <id> pad_initial_level
		                   // <false"> Low
		                   // <true"> High
		                   false);

		gpio_set_pin_pull_mode(PA23,
		                       // <y> Pull configuration
		                       // <id> pad_pull_config
		                       // <GPIO_PULL_OFF"> Off
		                       // <GPIO_PULL_UP"> Pull-up
		                       // <GPIO_PULL_DOWN"> Pull-down
		                       GPIO_PULL_OFF);

		gpio_set_pin_function(PA23,
		                      // <y> Pin function
		                      // <id> pad_function
		                      // <i> Auto : use driver pinmux if signal is imported by driver, else turn off function
		                      // <PINMUX_PA25H_USB_DP"> Auto
		                      // <GPIO_PIN_FUNCTION_OFF"> Off
		                      // <GPIO_PIN_FUNCTION_A"> A
		                      // <GPIO_PIN_FUNCTION_B"> B
		                      // <GPIO_PIN_FUNCTION_C"> C
		                      // <GPIO_PIN_FUNCTION_D"> D
		                      // <GPIO_PIN_FUNCTION_E"> E
		                      // <GPIO_PIN_FUNCTION_F"> F
		                      // <GPIO_PIN_FUNCTION_G"> G
		                      // <GPIO_PIN_FUNCTION_H"> H
		                      // <GPIO_PIN_FUNCTION_I"> I
		                      // <GPIO_PIN_FUNCTION_J"> J
		                      // <GPIO_PIN_FUNCTION_K"> K
		                      // <GPIO_PIN_FUNCTION_L"> L
		                      // <GPIO_PIN_FUNCTION_M"> M
		                      // <GPIO_PIN_FUNCTION_N"> N
		                      PINMUX_PA23H_USB_SOF_1KHZ);
}

/* The USB module requires a GCLK_USB of 48 MHz ~ 0.25% clock
 * for low speed and full speed operation. */
#if (CONF_GCLK_USB_FREQUENCY > (48000000 + 48000000 / 400)) || (CONF_GCLK_USB_FREQUENCY < (48000000 - 48000000 / 400))
#warning USB clock should be 48MHz ~ 0.25% clock, check your configuration!
#endif

void USB_0_CLOCK_init(void)
{

	hri_gclk_write_PCHCTRL_reg(GCLK, USB_GCLK_ID, CONF_GCLK_USB_SRC | GCLK_PCHCTRL_CHEN);
	hri_mclk_set_AHBMASK_USB_bit(MCLK);
	hri_mclk_set_APBBMASK_USB_bit(MCLK);
}

void USB_0_init(void)
{
	USB_0_CLOCK_init();
	usb_d_init();
	USB_0_PORT_init();
}

void WDT_0_CLOCK_init(void)
{
	hri_mclk_set_APBAMASK_WDT_bit(MCLK);
}

void WDT_0_init(void)
{
	WDT_0_CLOCK_init();
	wdt_init(&WDT_0, WDT);
}

void ClockInitInt(void);

void system_init(void)
{
	init_mcu();

	ClockInitInt();


	EVENT_SYSTEM_0_init();


	FLASH_0_init();

	TIMER_0_init();

	//USART_0_init();

	I2C_0_init();

	SPI_0_init();

	delay_driver_init();

	USB_0_init();

	WDT_0_init();
}

void ClockInitInt(void)
{
	//Initialisation for 120 MHz (Or any speed you want, this code is set to 120 MHz) from the internal 32KHz Oscillator.


	// CONFIGURE FLASH MEMORY WAIT STATES
	NVMCTRL->CTRLA.bit.RWS = 4; // 4WS allows up to 119 MHz, 5WS allows 120 MHz
	NVMCTRL->CTRLA.bit.AUTOWS = 1; // automatically determine the necessary wait states

	// CONFIGURE EXTERNAL 32K CRYSTAL OSCILLATOR
//	OSC32KCTRL->XOSC32K.bit.CGM = 1; // control gain mode: 1 = standard/XT 2 = high-speed/HS
//	OSC32KCTRL->XOSC32K.bit.STARTUP = 0; // oscillator startup time, 0 = 62 ms
//	OSC32KCTRL->XOSC32K.bit.ONDEMAND = 0; // always run
//	OSC32KCTRL->XOSC32K.bit.XTALEN = 1; // enable crystal driver circuit for XIN32/XOUT32 pins
//	OSC32KCTRL->XOSC32K.bit.EN32K = 1; // enable the 32 kHz output clock
//	OSC32KCTRL->XOSC32K.bit.ENABLE = 1;
//	while (!OSC32KCTRL->STATUS.bit.XOSC32KRDY); // wait until crystal oscillator is stable and ready to be used as a clock source
//	OSC32KCTRL->RTCCTRL.bit.RTCSEL = OSC32KCTRL_RTCCTRL_RTCSEL_XOSC32K_Val; // RTC should use the external 32K crystal

	// CONFIGURE MASTER CLOCK
	MCLK->CPUDIV.bit.DIV = 1; // use a divisor of 1 for the master clock

	//Configure ClockGen1 for PLL INTERNAL
	GCLK->GENCTRL[1].bit.SRC=4;     //Internal 32KHz Oscillator.
	GCLK->GENCTRL[1].bit.DIV = 1; // divisor 1 for the input clock from the PLL
	GCLK->GENCTRL[1].bit.GENEN = 1;

	GCLK->PCHCTRL[1].bit.GEN = 1;  //PERIPHERAL 1
	GCLK->PCHCTRL[1].bit.CHEN = 1;  //ENABLE CHANNEL

	// CONFIGURE PLL0
	OSCCTRL->Dpll[0].DPLLCTRLB.bit.REFCLK= 0; // use GCLK as the PLL reference clock
	OSCCTRL->Dpll[0].DPLLRATIO.reg = (3<<16) + 3661; // multiply OSC32K by 3662.11 to get 120 MHz (actual multiplier is LDR + 1 + LDRFRAC/32)  3661
	//OSCCTRL->Dpll[0].DPLLRATIO.reg = (3<<16) + 1464; // multiply OSC32K by 1464 to get 48 MHz (actual multiplier is LDR + 1 + LDRFRAC/32)  1464

	// errata: When using a low-frequency input clock on FDPLLn, several FDPLL unlocks may occur while the output
	// frequency is stable. Workaround: when using a low-frequency input clock on FDPLLn, enable the lock bypass
	// feature to avoid FDPLL unlocks.
	OSCCTRL->Dpll[0].DPLLCTRLB.bit.LBYPASS = 1; // CLK_DPLL0 output clock is always on, and not dependent on frequency lock
	OSCCTRL->Dpll[0].DPLLCTRLA.bit.ONDEMAND = 0; // always run
	OSCCTRL->Dpll[0].DPLLCTRLA.bit.ENABLE = 1;

//	while (!OSCCTRL->Dpll[0].DPLLSTATUS.bit.LOCK) ; // no point in checking DPLLSTATUS.bit.CLKRDY, because LBYPASS is enabled

	// CONFIGURE CLOCK GENERATOR 0
	GCLK->GENCTRL[0].bit.SRC = 7; // use PLL0 as the input
	GCLK->GENCTRL[0].bit.DIV = 1; // divisor 1 for the input clock from the PLL
	GCLK->GENCTRL[0].bit.GENEN = 1;

	// do peripheral clock initialization here...
}
