kamtar/dykodac/(commit log)

2019-06-16 init schematics commit
    [DykoDAC.sch, DykoDAC_CS4398.sch, DykoDAC_MCU.sch, DykoDAC_Output.sch, DykoDAC_Power.sch]
2019-06-19 mcu input and usb added, oscilators moved to DAC schematics
    [DykoDAC_CS4398.sch, DykoDAC_MCU.sch]
2019-06-20 changed filter values, and cap in osscilator power supply.
    [DykoDAC_Output.sch, DykoDAC_Power.sch]
2019-06-29 changed filter values started with PCB design
    [DykoDAC.kicad_pcb, DykoDAC_CS4398.sch, DykoDAC_MCU.sch, DykoDAC_Output.sch, DykoDAC_Power.sch]
2019-06-29 pcb dev.
    [DykoDAC.kicad_pcb, DykoDAC_Power.sch]
2019-06-30 changed usb protection IC
    [DykoDAC.kicad_pcb, DykoDAC_MCU.sch]
2019-08-10 lots of stuf ....
    [DykoDAC.kicad_pcb, DykoDAC_CS4398.sch, DykoDAC_MCU.sch, DykoDAC_Output.sch, DykoDAC_Power.sch]
2020-02-23 opamp filter pcb
    [DykoDAC.kicad_pcb, DykoDAC_CS4398.sch, DykoDAC_MCU.sch, DykoDAC_Output.sch, DykoDAC_Power.sch]
2020-02-23 pcb update
    [DykoDAC.kicad_pcb, DykoDAC_MCU.sch, DykoDAC_Output.sch]
2020-03-01 pdf update
    [DykoDAC_MCU.sch]
2020-03-06 minor chages
    [DykoDAC.kicad_pcb, DykoDAC_MCU.sch, DykoDAC_Output.sch]
2020-03-09 first revision finished
    [DykoDAC.kicad_pcb, DykoDAC_CS4398.sch, DykoDAC_MCU.sch, DykoDAC_Output.sch]
2020-03-09 fixed via
    [DykoDAC.kicad_pcb]
2020-03-11 fix gnd trace under oscillators
    [DykoDAC.kicad_pcb]
2020-03-11 new footprint
2020-03-11 lm317 fix
    [DykoDAC.kicad_pcb, DykoDAC_Power.sch]
2020-03-12 updated fuse
    [DykoDAC.kicad_pcb, DykoDAC_Power.sch]
2020-03-12 fuse footprint
2020-03-12 added vias
    [DykoDAC.kicad_pcb]
2020-03-12 ldo change
    [DykoDAC.kicad_pcb, DykoDAC_Power.sch]
2020-03-12 PRODUCTION - REV A
    [DykoDAC-B_Cu.gbr, DykoDAC-B_Mask.gbr, DykoDAC-B_SilkS.gbr, DykoDAC-Edge_Cuts.gbr, DykoDAC-F_Cu.gbr, DykoDAC-F_Mask.gbr, DykoDAC-F_SilkS.gbr, DykoDAC-NPTH-drl_map.gbr]
2020-03-13 3D update & pdf update
    [DykoDAC.kicad_pcb]
2020-03-13 9V -> 12V symbol
    [DykoDAC_MCU.sch, DykoDAC_Output.sch, DykoDAC_Power.sch]
2020-03-17 PRODUCTION - REV.B - rotated 5Vreg. fixed 78l05, fixed wrong polygon
    [DykoDAC-B_Cu.gbr, DykoDAC-B_Mask.gbr, DykoDAC-B_SilkS.gbr, DykoDAC-Edge_Cuts.gbr, DykoDAC-F_Cu.gbr, DykoDAC-F_Mask.gbr, DykoDAC-F_SilkS.gbr, DykoDAC-NPTH-drl_map.gbr]
2020-03-17 minor changes & pdf update
    [DykoDAC.kicad_pcb, DykoDAC_MCU.sch, DykoDAC_Output.sch, DykoDAC_Power.sch]
2020-03-17 cosmetic changes
    [DykoDAC_CS4398.sch, DykoDAC_MCU.sch, DykoDAC_Power.sch]
2020-04-13 first "working" prototype
2020-04-19 16bit/44.1 final prototype
2020-05-07 new pdf and minor changes in schematics and fw
    [DykoDAC_Output.sch, DykoDAC_Power.sch]
